ElFishle/WMRP/layout/KiCAD/wmrp/wmrp.kicad_pcb

## KiCad design layout/KiCAD/wmrp/wmrp.kicad_pcb (2022-12-20)

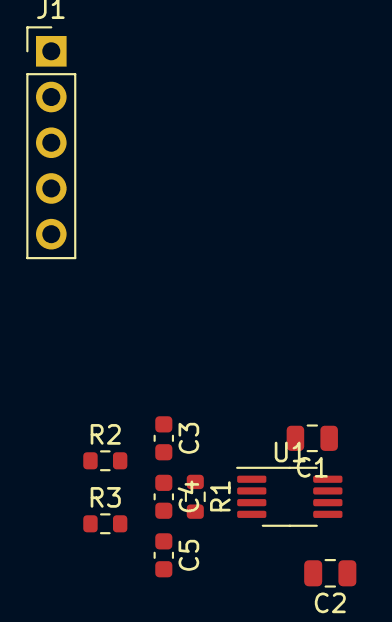
[picture p1: board wmrp.kicad_pcb from above]

Board: 2 copper layers, 10 parts (0 on the bottom side), 9 nets, no tracks yet.

Parts:
C1, C2: 100nF; C_0805_2012Metric
C3, C5: 1nF; C_0603_1608Metric
C4: 22nF; C_0603_1608Metric
J1: DIN-5; PinHeader_1x05_P2.54mm_Vertical
R1: 1k; R_0603_1608Metric
R2, R3: 22k; R_0603_1608Metric
U1: AD8236; MSOP-8_3x3mm_P0.65mm

Connections:
+5V: C1.1, U1.8 (Vs+)
-5V: C2.1, U1.5 (Vs-)
/SENSOR-: J1.3, R2.1
/TIP_SENSOR+: J1.4, R3.1
GND: C1.2, C2.2, C3.1, C5.2, U1.6 (Ref)
unnamed: R1.1, U1.2 (Rg)
unnamed: R1.2, U1.3 (Rg)
unnamed: C3.2, C4.1, R2.2, U1.1 (-)
unnamed: C4.2, C5.1, R3.2, U1.4 (+)
