ElFishle/WMRP/layout/eagle/wmrp_eagle/wmrp.brd

## EAGLE design layout/eagle/wmrp_eagle/wmrp.brd (2022-12-20)

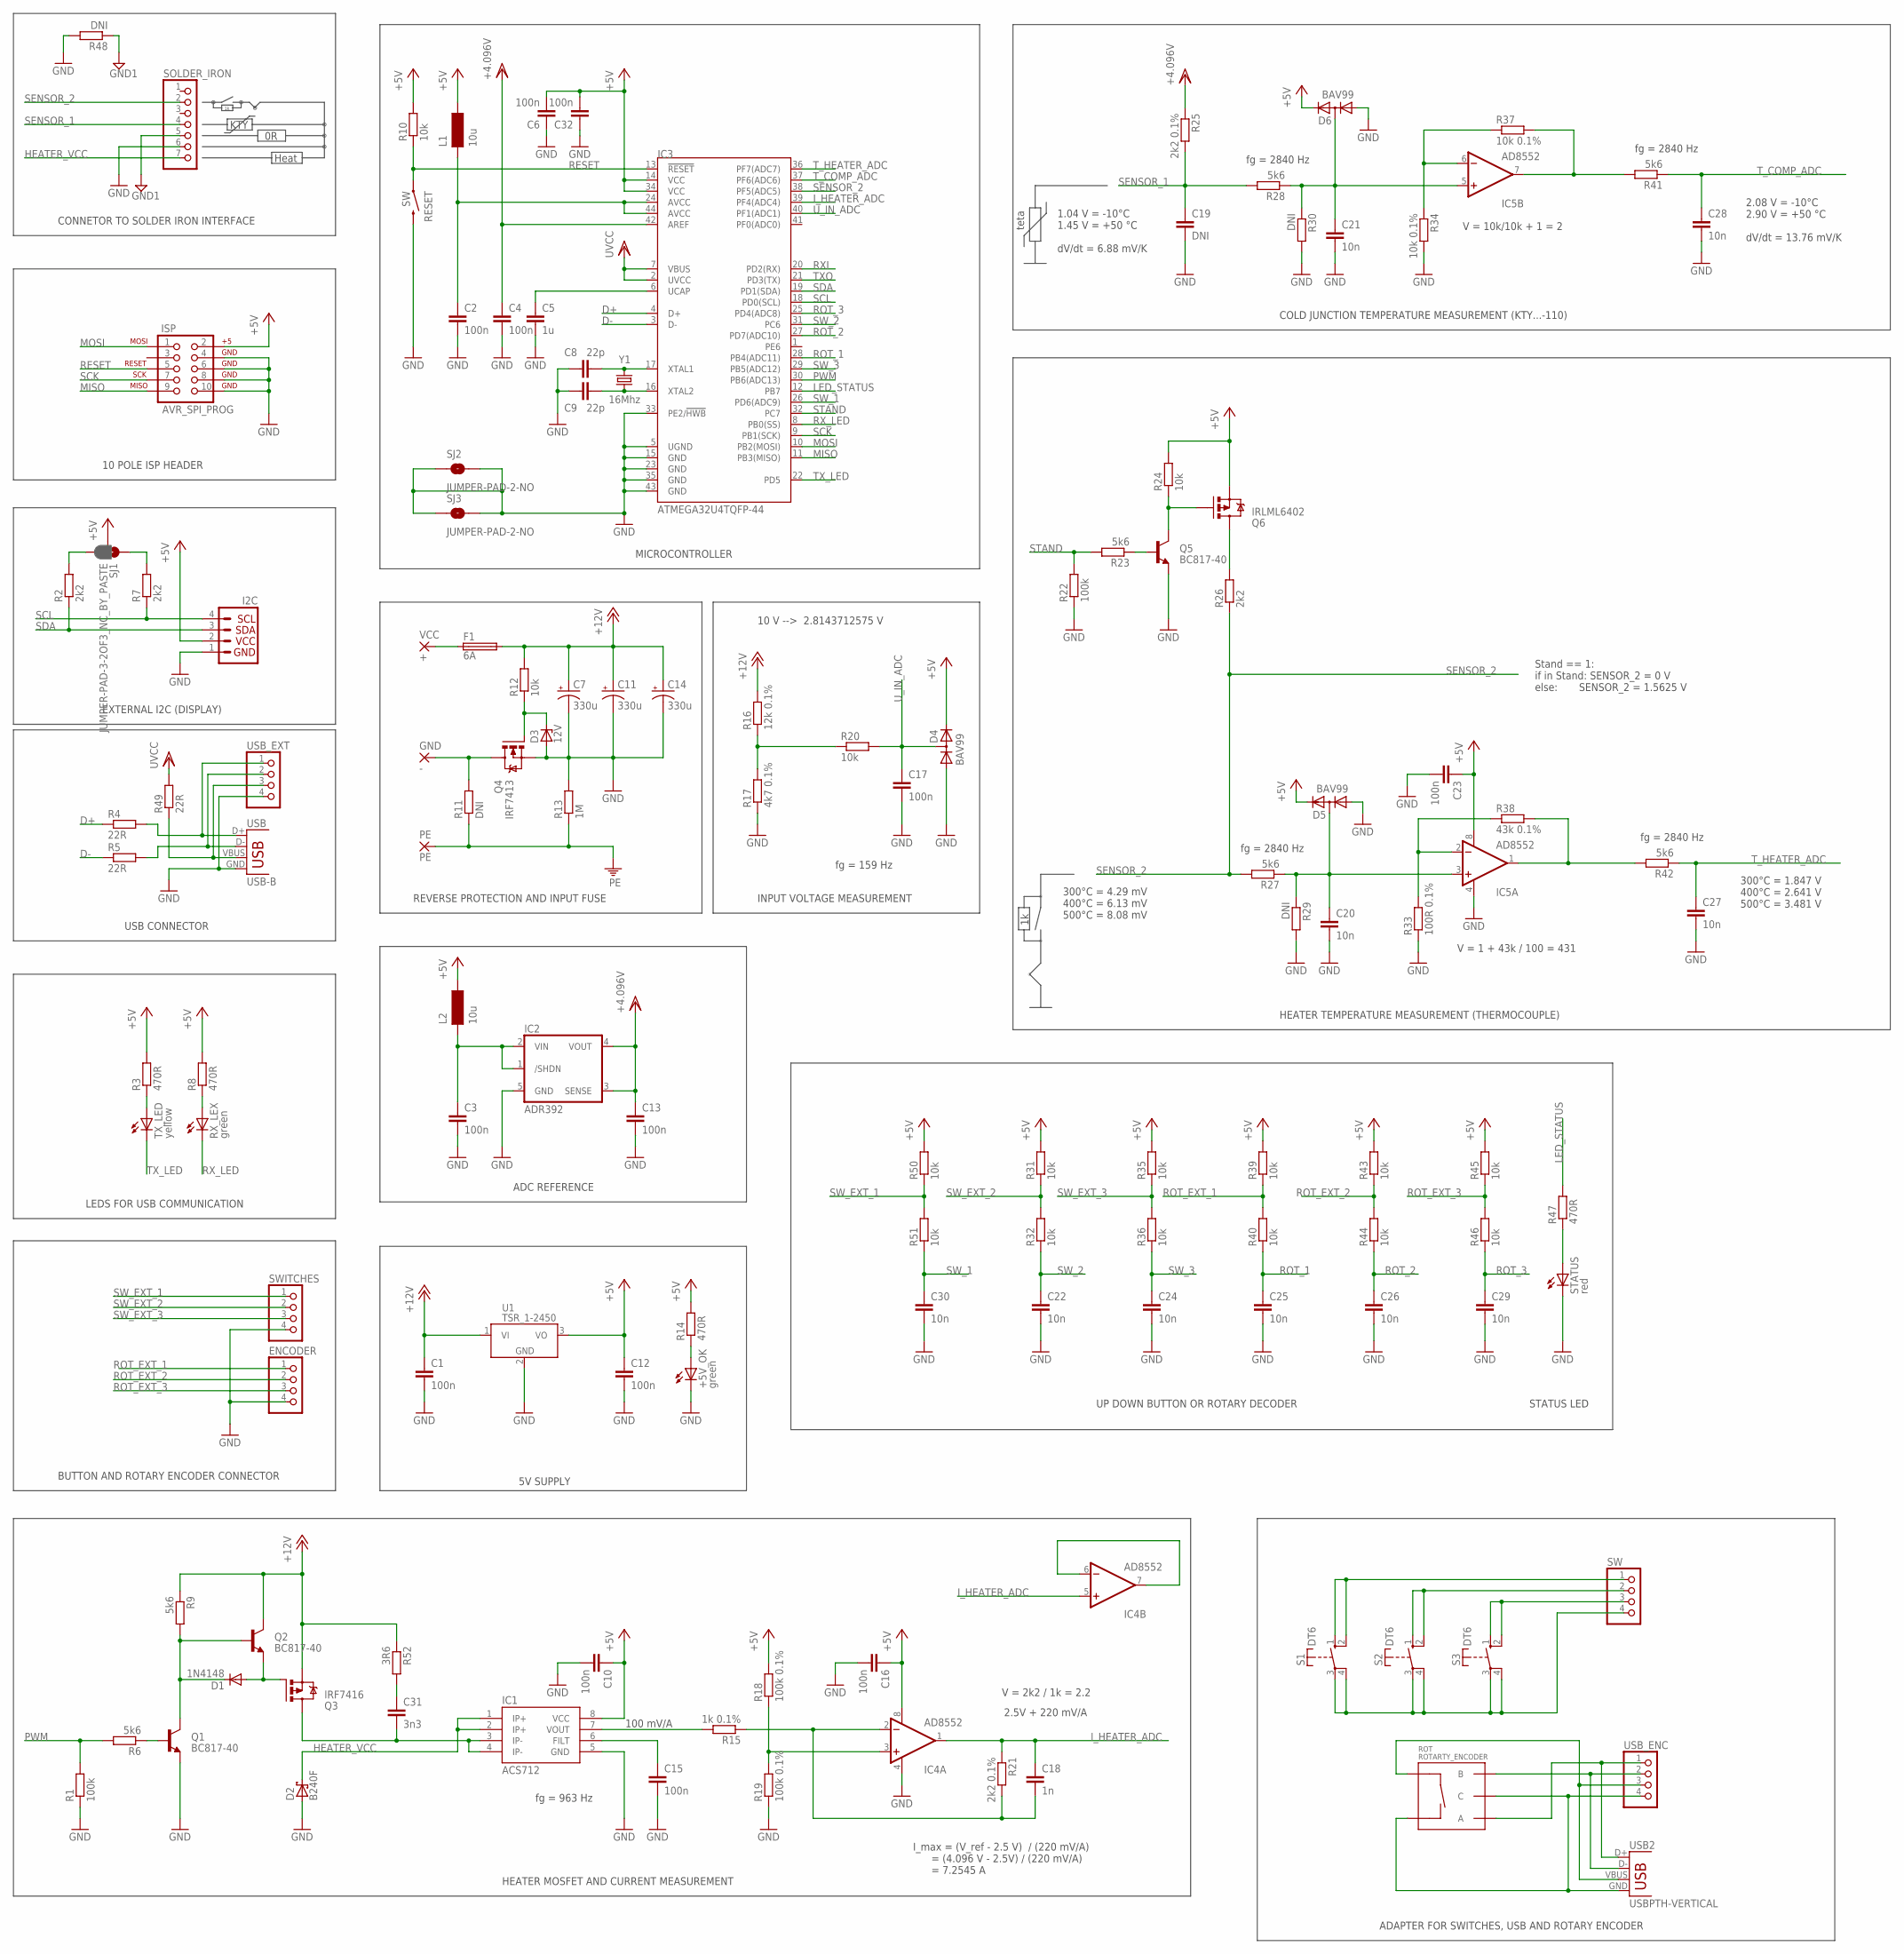
[picture p2: schematic wmrp.sch]

Parts:
+5V_OK: green; CHIPLED_1206
C1, C2, C3, C4, C6, C10, C12, C13, C15, C16, C17, C23, C32: 100n; C1206
C5: 1u; C1206
C7, C11, C14: 330u; CPOL-RADIAL-1000UF-25V
C8, C9: 22p; C1206
C18: 1n; C1206
C19: DNI; C1206
C20, C21, C22, C24, C25, C26, C27, C28, C29, C30: 10n; C1206
C31: 3n3; C1206
D1: 1N4148; MINIMELF
D2: B240F; SMB
D3: 12V; SOT23
D4, D5, D6: BAV99; SOT23
ENCODER: PINHD-1X4; 1X04
F1: 6A; SH22,5
GND: -; 2,2
I2C: I2C_STANDARD; 1X04
IC1: ACS712; SO08
IC2: ADR392; SOT23-5
IC3: ATMEGA32U4TQFP-44; TQFP44
IC4, IC5: AD8552; SO08
ISP: AVR_SPI_PROG; AVR_ICSP
L1, L2: 10u; INDUCTOR-1206
PE: PE; 2,2
Q1, Q2, Q5: BC817-40; SOT23-3
Q3: IRF7416; SO-08
Q4: IRF7413; SO-08
Q6: IRLML6402; SOT23-3
R1, R22: 100k; R1206
R2, R7, R26: 2k2; R1206
R3, R8, R14, R47: 470R; R1206
R4, R5, R49: 22R; R1206
R6, R9, R23, R27, R28, R41, R42: 5k6; M1206
R10, R12, R20, R24, R31, R32, R35, R36, R39, R40, R43, R44, R45, R46, R50, R51: 10k; R1206
R11, R48: DNI; R1206
R13: 1M; R1206
R15: 1k 0.1%; M1206
R16: 12k 0.1%; R1206
R17: 4k7 0.1%; R1206
R18, R19: 100k 0.1%; M1206
R21, R25: 2k2 0.1%; M1206
R29, R30: DNI; M1206
R33: 100R 0.1%; M1206
R34, R37: 10k 0.1%; M1206
R38: 43k 0.1%; M1206
R52: 3R6; M1206
RESET: SW; TACTILE-PTH
ROT: ROTARTY_ENCODER; ROTARY_ENC_PLAIN
RX_LEX: green; CHIPLED_1206
S1, S2, S3: DT6
SJ1: JUMPER-PAD-3-2OF3_NC_BY_PASTE; PAD-JUMPER-3-2OF3_NC_BY_PASTE_YES_SILK_FULL_BOX
SJ2, SJ3: JUMPER-PAD-2-NO; PAD-JUMPER-2-NO_NO_SILK
SOLDER_IRON: PINHD-1X7; 1X07
STATUS: red; CHIPLED_1206
SW: PINHD-1X4; 1X04
SWITCHES: PINHD-1X4; 1X04
TX_LED: yellow; CHIPLED_1206
U1: TSR_1-2450; TSR-1
USB: USB-B; USB-B-PTH
USB2: USBPTH-VERTICAL; USB-B-PTH-VERTICAL
USB_ENC: PINHD-1X4; 1X04
USB_EXT: PINHD-1X4; 1X04
VCC: +; 2,2
Y1: 16Mhz; HC49US

Connections:
+4.096V: C4.1, C13.1, IC2.3 (SENSE), IC2.4 (VOUT), IC3.42 (AREF), R25.1
+5V: C6.2, C10.1, C12.1, C16.1, C23.1, C32.2, D4.2 (C2), D5.2 (C2), D6.2 (C2), I2C.2, IC1.8 (VCC), IC3.14 (VCC), IC3.34 (VCC), IC4.8 (V+), IC5.8 (V+), ISP.2, L1.P$1 (1), L2.P$1 (1), Q6.2 (S), R3.2, R8.2, R10.2, R14.2, R18.2, R24.2, R31.2, R35.2, R39.2, R43.2, R45.2, R50.2, SJ1.2, U1.3 (VO)
+12V: C1.1, C7.1 (+), C11.1 (+), C14.1 (+), F1.2, Q2.3 (C), Q3.1 (S), Q3.2 (S), Q3.3 (S), R9.1, R12.2, R16.2, R52.1, U1.1 (VI)
AVCC: C2.1, IC3.24 (AVCC), IC3.44 (AVCC), L1.P$2 (2)
D+: IC3.4 (D+), R4.1
D-: IC3.3 (D-), R5.1
GND: +5V_OK.C, C1.2, C2.2, C3.2, C4.2, C5.2, C6.1, C7.2 (-), C8.1, C9.1, C10.2, C11.2 (-), C12.2, C13.2, C14.2 (-), C15.2, C16.2, C17.2, C19.2, C20.2, C21.2, C22.2, C23.2, C24.2, C25.2, C26.2, C27.2, C28.2, C29.2, C30.2, C32.1, D2.A, D3.1 (A), D4.1 (A1), D5.1 (A1), D6.1 (A1), ENCODER.4, I2C.1, IC1.5 (GND), IC2.5 (GND), IC3.5 (UGND), IC3.15 (GND), IC3.23 (GND), IC3.33 (PE2/!HWB), IC3.35 (GND), IC3.43 (GND), IC4.4 (V-), IC5.4 (V-), ISP.4, ISP.6, ISP.8, ISP.10, Q1.2 (E), Q4.1 (S), Q4.2 (S), Q4.3 (S), Q5.2 (E), R1.1, R13.2, R17.1, R19.1, R22.1, R29.2, R30.2, R33.1, R34.2, R48.2, RESET.3 (2), SJ2.1, SJ2.2, SJ3.1, SJ3.2, SOLDER_IRON.6, STATUS.C, SWITCHES.4, U1.2 (GND), USB.GND, USB_EXT.4
GND1: R48.1, SOLDER_IRON.5
HEATER_VCC: D2.C, IC1.1 (IP+), IC1.2 (IP+), SOLDER_IRON.7
I_HEATER_ADC: C18.1, IC3.39 (PF4(ADC4)), IC4.1 (OUT), IC4.5 (+IN), R21.1
LED_STATUS: IC3.12 (PB7), R47.2
MISO: IC3.11 (PB3(MISO)), ISP.9
MOSI: IC3.10 (PB2(MOSI)), ISP.1
unnamed: GND.1, Q4.5 (D), Q4.6 (D), Q4.7 (D), Q4.8 (D), R11.2
unnamed: D3.3 (C), Q4.4 (G), R12.1
unnamed: D1.C, Q1.3 (C), Q2.1 (B), R9.2
unnamed: Q1.1 (B), R6.1
unnamed: F1.1, VCC.1
unnamed: R8.1, RX_LEX.A
unnamed: S1.3, S1.4, S2.3, S2.4, S3.3, S3.4, SW.4
unnamed: S1.1 (S), S1.2 (S), SW.1
unnamed: R4.2, USB.D+, USB_EXT.1
unnamed: R5.2, USB.D-, USB_EXT.2
unnamed: R16.1, R17.2, R20.1
unnamed: S2.1 (S), S2.2 (S), SW.2
unnamed: S3.1 (S), S3.2 (S), SW.3
unnamed: R2.2, SJ1.3
unnamed: Q5.3 (C), Q6.1 (G), R24.1
unnamed: C15.1, IC1.6 (FILT)
unnamed: Q5.1 (B), R23.1
unnamed: IC4.3 (+IN), R18.1, R19.2
unnamed: R3.1, TX_LED.A
unnamed: IC1.7 (VOUT), R15.2
unnamed: C18.2, IC4.2 (-IN), R15.1, R21.2
unnamed: C20.1, D5.3 (C1A2), IC5.3 (+IN), R27.1, R29.1
unnamed: Q6.3 (D), R26.2
unnamed: IC5.2 (-IN), R33.2, R38.1
unnamed: C21.1, D6.3 (C1A2), IC5.5 (+IN), R28.1, R30.1
unnamed: D1.A, Q2.2 (E), Q3.4 (G)
unnamed: IC5.6 (-IN), R34.1, R37.1
unnamed: C31.2, IC1.3 (IP-), IC1.4 (IP-), Q3.5 (D), Q3.6 (D), Q3.7 (D), Q3.8 (D)
unnamed: R7.2, SJ1.1
unnamed: C3.1, IC2.1 (/SHDN), IC2.2 (VIN), L2.P$2 (2)
unnamed: R49.1, USB.VBUS, USB_EXT.3
unnamed: R47.1, STATUS.A
unnamed: +5V_OK.A, R14.1
unnamed: IC4.6 (-IN), IC4.7 (OUT)
unnamed: C31.1, R52.2
unnamed: IC5.1 (OUT), R38.2, R42.2
unnamed: IC5.7 (OUT), R37.2, R41.2
PE: PE.1, R11.1, R13.1
PWM: IC3.30 (PB6(ADC13)), R1.2, R6.2
RESET: IC3.13 (!RESET), ISP.5, R10.1, RESET.1
ROT_1: C25.1, IC3.28 (PB4(ADC11)), R40.1
ROT_2: C26.1, IC3.27 (PD7(ADC10)), R44.1
ROT_3: C29.1, IC3.25 (PD4(ADC8)), R46.1
ROT_A_D+: ROT.A, USB2.D+, USB_ENC.1
ROT_B_D-: ROT.B, USB2.D-, USB_ENC.2
ROT_C_GND: ROT.C, ROT.SW-, USB2.GND, USB_ENC.4
ROT_EXT_1: ENCODER.1, R39.1, R40.2
ROT_EXT_2: ENCODER.2, R43.1, R44.2
ROT_EXT_3: ENCODER.3, R45.1, R46.2
ROT_SW_VBUS: ROT.SW+, USB2.VBUS, USB_ENC.3
RXI: IC3.20 (PD2(RX))
RX_LED: IC3.8 (PB0(SS)), RX_LEX.C
SCK: IC3.9 (PB1(SCK)), ISP.7
SCL: I2C.4, IC3.18 (PD0(SCL)), R7.1
SDA: I2C.3, IC3.19 (PD1(SDA)), R2.1
SENSOR_1: C19.1, R25.2, R28.2, SOLDER_IRON.4
SENSOR_2: IC3.38 (PF5(ADC5)), R26.1, R27.2, SOLDER_IRON.2
STAND: IC3.32 (PC7), R22.2, R23.2
SW_1: C30.1, IC3.26 (PD6(ADC9)), R51.1
SW_2: C22.1, IC3.31 (PC6), R32.1
SW_3: C24.1, IC3.29 (PB5(ADC12)), R36.1
SW_EXT_1: R50.1, R51.2, SWITCHES.1
SW_EXT_2: R31.1, R32.2, SWITCHES.2
SW_EXT_3: R35.1, R36.2, SWITCHES.3
TXO: IC3.21 (PD3(TX))
TX_LED: IC3.22 (PD5), TX_LED.C
T_COMP_ADC: C28.1, IC3.37 (PF6(ADC6)), R41.1
T_HEATER_ADC: C27.1, IC3.36 (PF7(ADC7)), R42.1
UCAP: C5.1, IC3.6 (UCAP)
UVCC: IC3.2 (UVCC), IC3.7 (VBUS), R49.2
U_IN_ADC: C17.1, D4.3 (C1A2), IC3.40 (PF1(ADC1)), R20.2
XTAL1: C8.2, IC3.17 (XTAL1), Y1.2
XTAL2: C9.2, IC3.16 (XTAL2), Y1.1

Notes on the sheet:
REVERSE PROTECTION AND INPUT FUSE
CONNETOR TO SOLDER IRON INTERFACE
fg = 159 Hz
ADC REFERENCE
MICROCONTROLLER
LEDS FOR USB COMMUNICATION
USB CONNECTOR
EXTERNAL I2C (DISPLAY)
10 POLE ISP HEADER
HEATER TEMPERATURE MEASUREMENT (THERMOCOUPLE)
COLD JUNCTION TEMPERATURE MEASUREMENT (KTY...-110)
UP DOWN BUTTON OR ROTARY DECODER
100 mV/A
2.5V + 220 mV/A
teta
V = 10k/10k + 1 = 2
V = 1 + 43k / 100 = 431
1.04 V = -10°C 1.45 V = +50 °C dV/dt = 6.88 mV/K
2.08 V = -10°C 2.90 V = +50 °C dV/dt = 13.76 mV/K
V = 2k2 / 1k = 2.2
I_max = (V_ref - 2.5 V) / (220 mV/A) = (4.096 V - 2.5V) / (220 mV/A) = 7.2545 A
300°C = 4.29 mV 400°C = 6.13 mV 500°C = 8.08 mV
HEATER MOSFET AND CURRENT MEASUREMENT
INPUT VOLTAGE MEASUREMENT
STATUS LED
5V SUPPLY
Heat
KTY
fg = 2840 Hz
fg = 963 Hz
300°C = 1.847 V 400°C = 2.641 V 500°C = 3.481 V
BUTTON AND ROTARY ENCODER CONNECTOR
10 V --> 2.8143712575 V
Stand == 1: if in Stand: SENSOR_2 = 0 V else: SENSOR_2 = 1.5625 V
ADAPTER FOR SWITCHES, USB AND ROTARY ENCODER

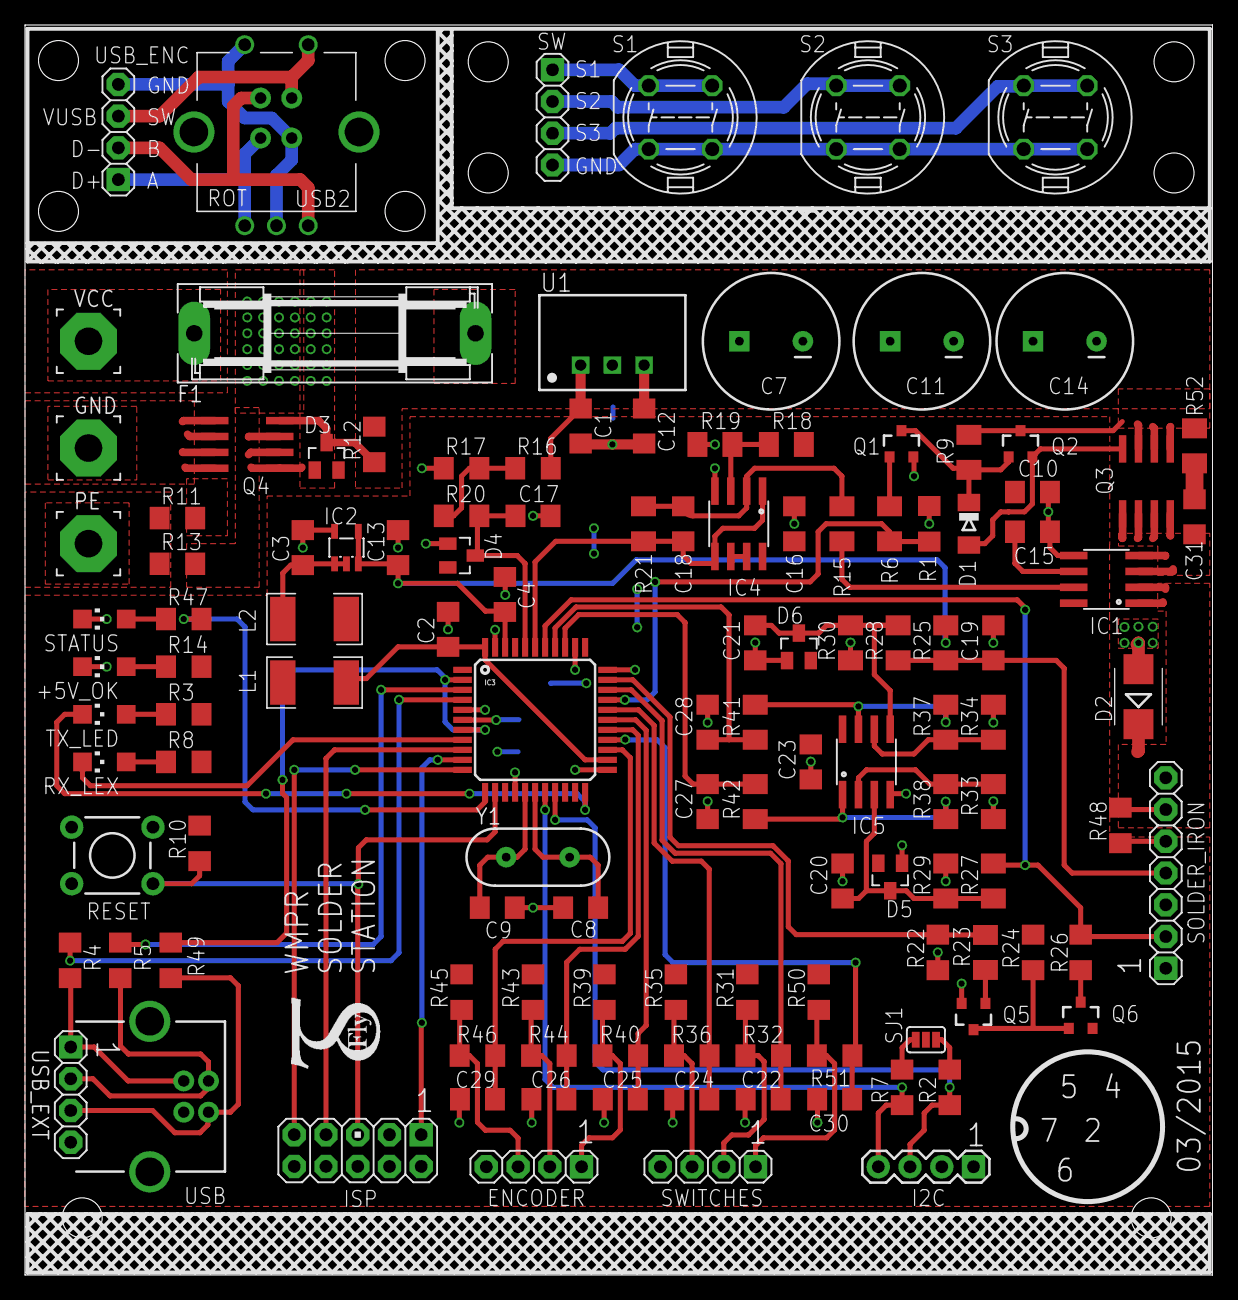
[picture p3: board wmrp.brd from above]

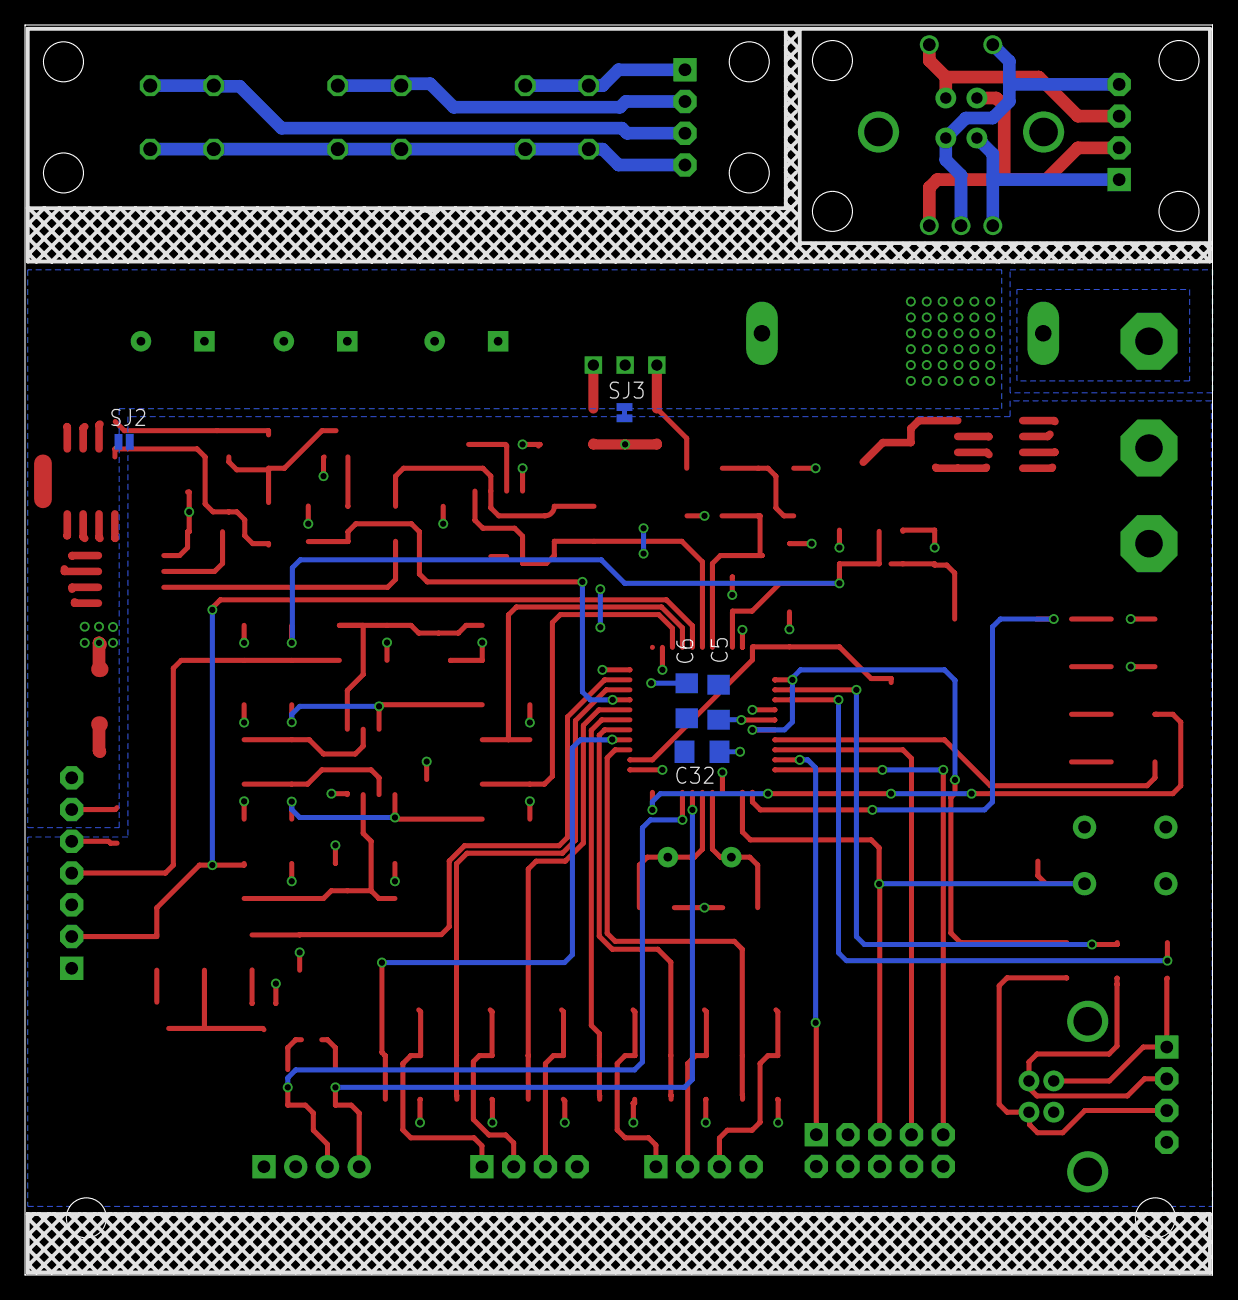
[picture p4: board wmrp.brd from below]

Board: 2 copper layers, 95.0 x 100.0 mm, 132 parts (5 on the bottom side), 84 nets.

Other parts of the board:
U$1: LOGO+
