ElFishle/WMRP/(commit log)

2019-07-11 Started KiCAD schematic
    [wmrp.kicad_pcb, wmrp.sch]
2022-12-20 Convert project to KiCAD 6
    [wmrp.kicad_sch, wmrp.sch]
2022-12-20 Unpacked eagle project for editing
    [wmrp.brd, wmrp.sch]
2022-12-20 First try to use instrumentation amplifier for thermocouple reading
    [wmrp.kicad_pcb, wmrp.kicad_sch]
